bruprescott/CTDizzle/Arduino_MKRZero_Mk4/Documentation/Resources.md

This page will continue to be updated as resources are discovered.

### Datasheets and Part Documentation
- [Atlas-Scientific EC EZO Datasheet](https://www.atlas-scientific.com/_files/_datasheets/_circuit/EC_EZO_Datasheet.pdf)
- [Atlas-Scientific K1.0 Probe Datasheet](https://www.atlas-scientific.com/_files/_datasheets/_probe/EC_K_1.0_probe.pdf)
- [Atlas-Scientific EC Accuracy Graph](https://www.atlas-scientific.com/_files/instructions/conductivity_accuracy_graph.pdf)
- [Atlas-Scientific EC Wiring Diagram](https://www.atlas-scientific.com/_files/instructions/ezo-ec-wiringdiagram.pdf)
- [MS5837 Pressure Sensor Datasheet](http://www.te.com/commerce/DocumentDelivery/DDEController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)
- [TSYS01 Temperature Sensor Datasheet](http://www.te.com/commerce/DocumentDelivery/DDEController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)
- [Watertight Enclosure Specifications](http://docs.bluerobotics.com/watertight-enclosures/)

### Useful Examples
- [DeadOn RTC Guide](https://learn.sparkfun.com/tutorials/deadon-rtc-breakout-hookup-guide)
- [Adafruit Temp and Light Logger](https://github.com/adafruit/Light-and-Temp-logger)
- [mbed SD Module Example](https://developer.mbed.org/cookbook/SD-Card-File-System)
- [Atlas-Scientific Cable Cutting Guide](https://www.atlas-scientific.com/_files/_app_notes/how-to-properly-cut-probe-cables.pdf)

### Literature
- [SeaBird Appnote 14](http://www.seabird.com/document/an14-1978-practical-salinity-scale)
- [SeaBird Appnote 69](http://www.seabird.com/document/an69-conversion-pressure-depth)
- [SeaBird Appnote 82](http://www.seabird.com/document/an82-guide-specifying-ctd)
- [SeaBird Appnote 90](http://www.seabird.com/document/an90-absolute-salinity-and-teos-10-sea-birds-implementation)
- [Algorithms for computation of fundamental properties of seawater](http://www.jodc.go.jp/info/ioc_doc/UNESCO_tech/059832eb.pdf)
- [SBE Data Processing Manual](http://www.seabird.com/sites/default/files/documents/SBEDataProcessing_7.26.7.pdf)
