bruprescott/CTDizzle/Arduino_MKRZero_Mk4/Documentation/Images/3.PNG

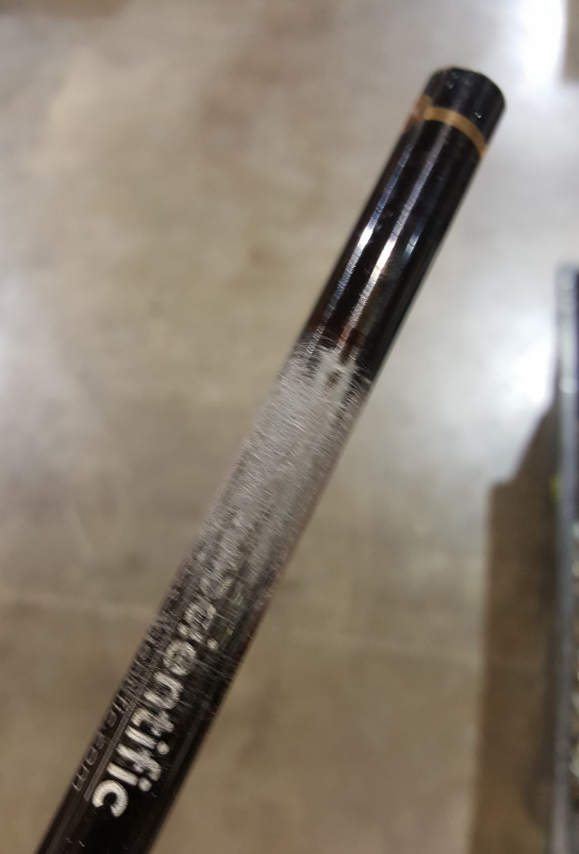
Arduino_MKRZero_Mk4/Documentation/Images/3.PNG
