bruprescott/CTDizzle/Arduino_MKRZero_Mk4/Documentation/Images/BadUrethane.jpg

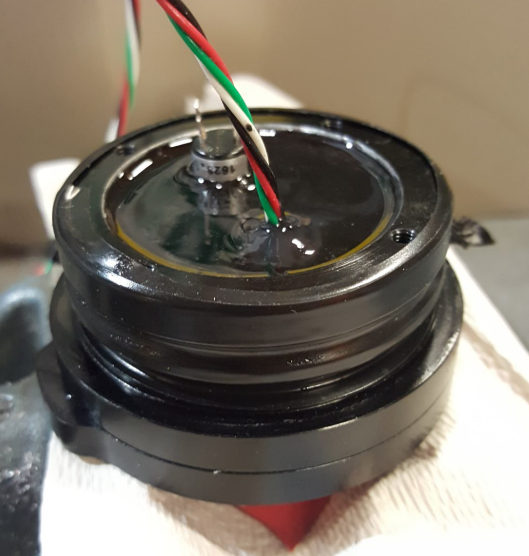
Arduino_MKRZero_Mk4/Documentation/Images/BadUrethane.jpg
