bruprescott/CTDizzle/Arduino_MKRZero_Mk4/Documentation/Images/CapInsideView.jpg

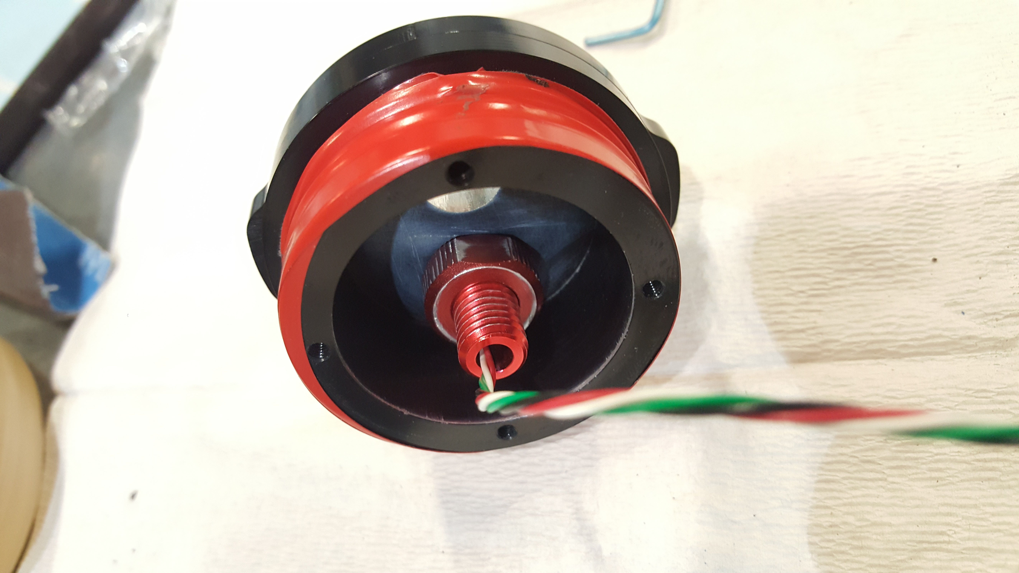
Arduino_MKRZero_Mk4/Documentation/Images/CapInsideView.jpg
