bruprescott/CTDizzle/Arduino_MKRZero_Mk4/Documentation/Images/Complete2.jpg

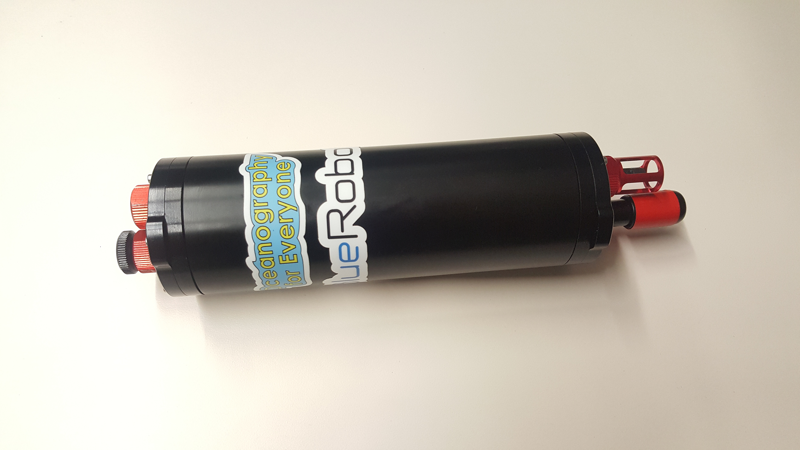
Arduino_MKRZero_Mk4/Documentation/Images/Complete2.jpg
