bruprescott/CTDizzle/Arduino_MKRZero_Mk4/Documentation/Images/EZOBend.jpg

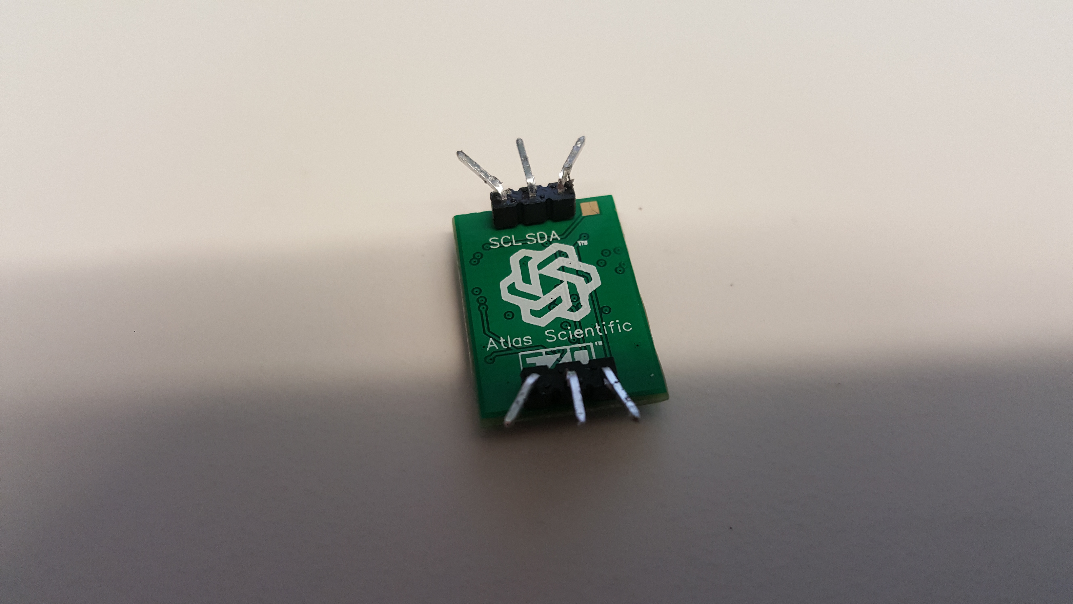
Arduino_MKRZero_Mk4/Documentation/Images/EZOBend.jpg
