bruprescott/CTDizzle/Arduino_MKRZero_Mk4/Documentation/Images/OceanShores1.PNG

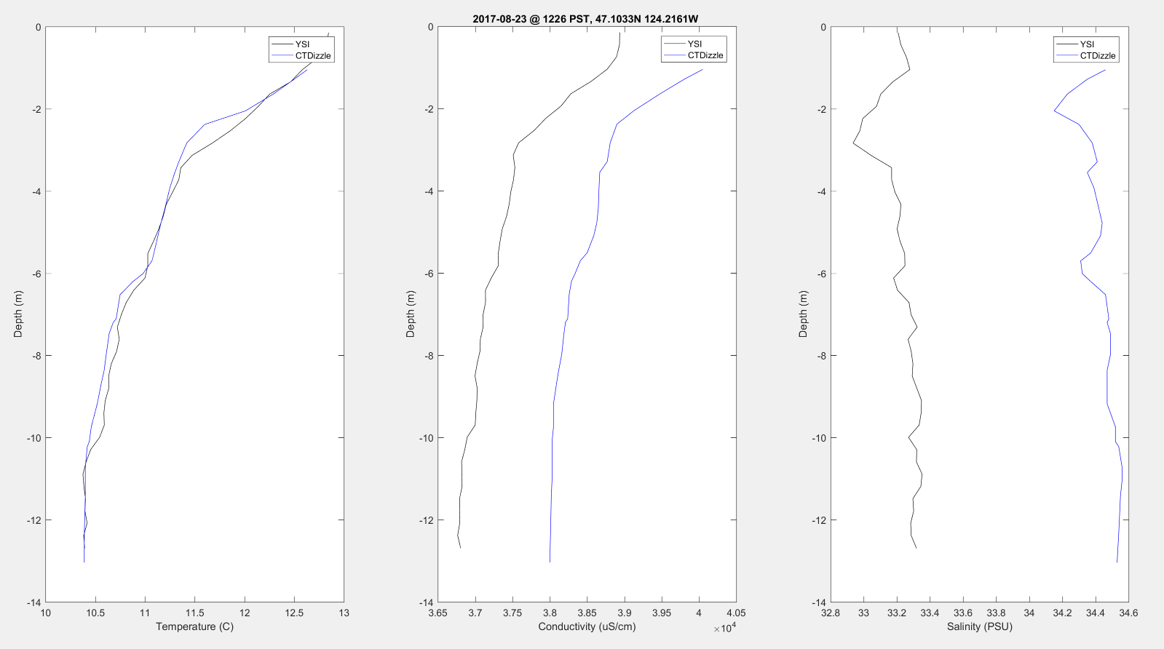
Arduino_MKRZero_Mk4/Documentation/Images/OceanShores1.PNG
