bruprescott/CTDizzle/Arduino_MKRZero_Mk4/Documentation/Images/PressureCap.jpg

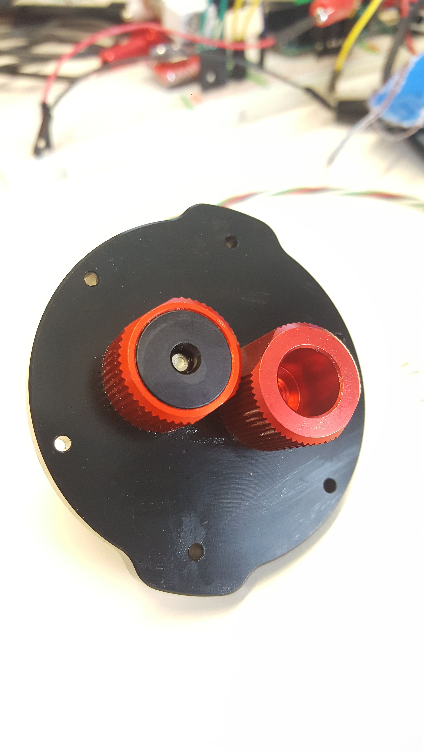
Arduino_MKRZero_Mk4/Documentation/Images/PressureCap.jpg
