bruprescott/CTDizzle/Arduino_MKRZero_Mk4/Documentation/Images/ProbeLeads.jpg

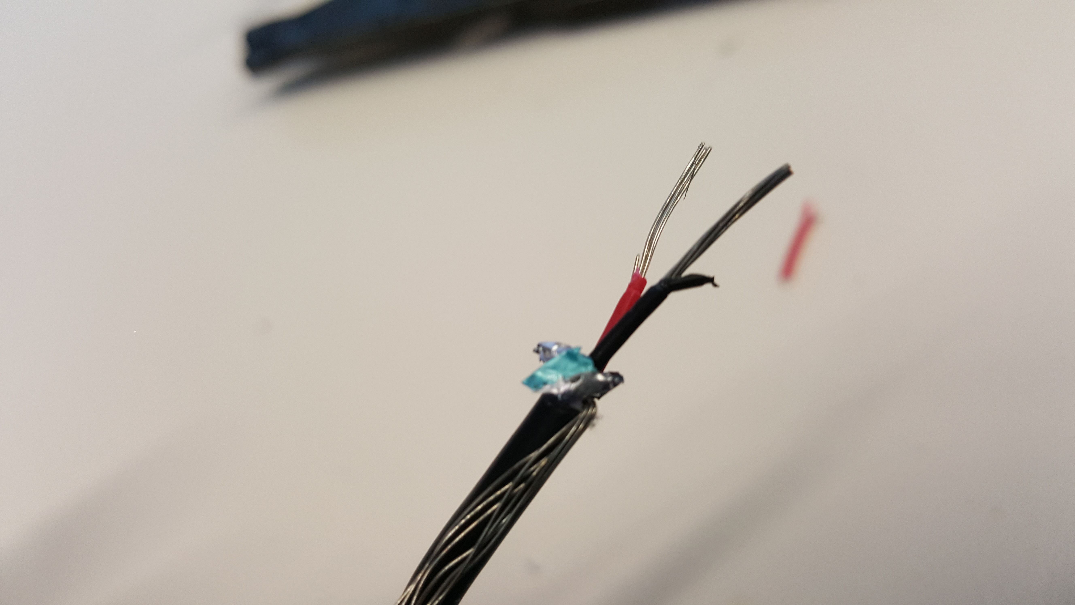
Arduino_MKRZero_Mk4/Documentation/Images/ProbeLeads.jpg
