bruprescott/CTDizzle/Arduino_MKRZero_Mk4/Documentation/Images/Protoboard2.jpg

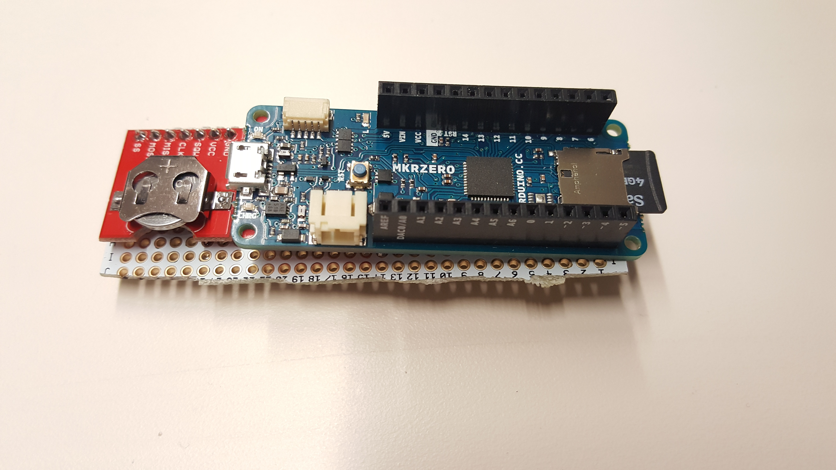
Arduino_MKRZero_Mk4/Documentation/Images/Protoboard2.jpg
