bruprescott/CTDizzle/Arduino_MKRZero_Mk4/Documentation/Images/SerialOutput.PNG

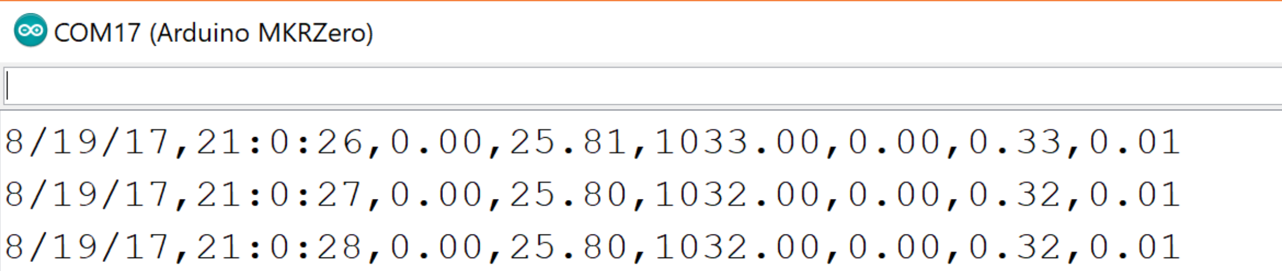
Arduino_MKRZero_Mk4/Documentation/Images/SerialOutput.PNG
