bruprescott/CTDizzle/Arduino_MKRZero_Mk4/Documentation/Images/TapedFlange.jpg

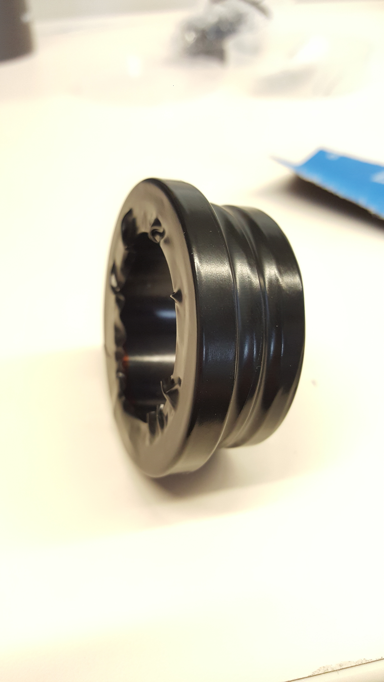
Arduino_MKRZero_Mk4/Documentation/Images/TapedFlange.jpg
