bruprescott/CTDizzle/Arduino_MKRZero_Mk4/Documentation/Images/WOPressure.jpg

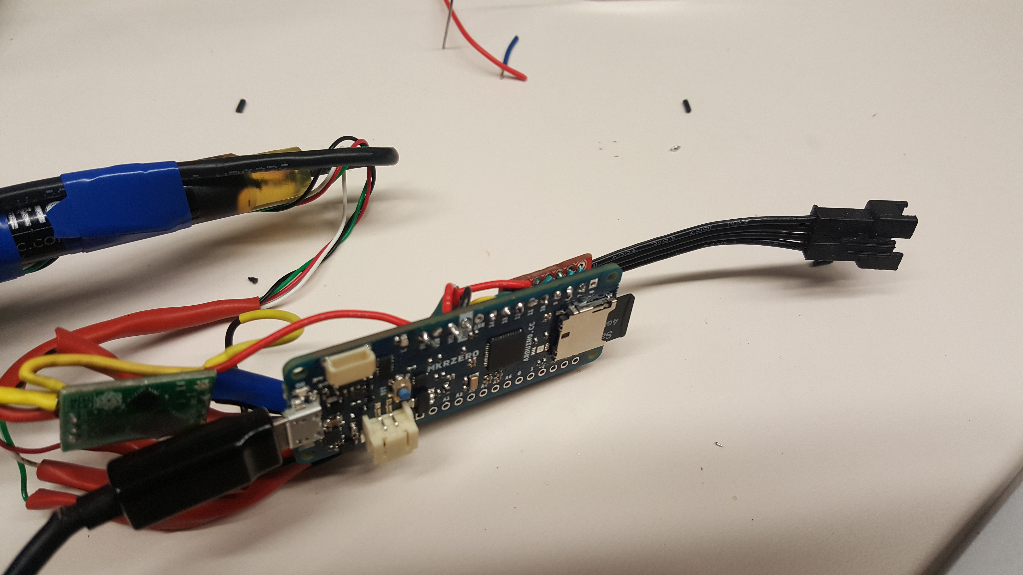
Arduino_MKRZero_Mk4/Documentation/Images/WOPressure.jpg
