bruprescott/CTDizzle/Adafruit_M0_Mk5/M0_PartsList.md

#### Primary Electronics List
|Part|Vendor|Price|Note|
|:---|:---|:---|:---|
|[Feather M0 Bluefruit LE](https://www.adafruit.com/product/2995?gclid=EAIaIQobChMIo-OggMH52wIVAtlkCh2x8AxQEAAYAiAAEgIEcPD_BwE)|Adafruit|$29.95|
|[Adalogger Featherwing](https://www.adafruit.com/product/2922)|Adafruit|$8.95|Includes RTC and SD module. +/- 12min per year accuracy
|[Celsius Fast-Response Temp Sensor](https://www.bluerobotics.com/store/electronics/celsius-sensor-r1/)|Blue Robotics|$56|+/- 0.1 C accuracy|
|[Bar30 High-Res Depth Sensor](https://www.bluerobotics.com/store/electronics/bar30-sensor-r1/)|Blue Robotics|$68|+/- 100 mbar accuracy
|[EC EZO K1.0 Kit](https://www.atlas-scientific.com/product_pages/kits/ec_k1_0_kit.html)|Atlas Scientific|$215|
|[Isolated EC EZO Carrier](https://www.atlas-scientific.com/product_pages/components/single_carrier_iso.html)|Atlas Scientific|$48|

#### Other Parts List
|Part|Vendor|Price|Note|
|:---|:---|:---|:---|
|[Short Feather Headers Kit - Female](https://www.adafruit.com/product/2940)|Adafruit|$2|
|[Short Feather Headers Kit - Male](https://www.adafruit.com/product/3002)|Adafruit|$1|
|[Featherwing Doubler](https://www.adafruit.com/product/2890)|Adafruit|$8|
|[Feather Terminal Blocks](https://www.adafruit.com/product/3173)|Adafruit|$6|
