bruprescott/CTDizzle/Arduino_MKRZero_Mk4/Mk4Parts_List.md

Here is a list of parts used to build the CTDizzle Mk4, their vendor location, and the approximate cost for each item. You can probably find them elsewhere for cheaper and in less quantity. Some items from this list will provide enough parts for multiple CTDs. Prices do not include shipping, but I've done my best to select as few of vendors as possible.

Please note that you can adapt the CTDizzle to use sensors and boards of your own choosing, but it is your responsibility to ensure that they are compatible. For example, if you are not concerned about size and want to implement a larger battery, you can use the 3" watertight enclosure, but be aware that you may need to drill your own holes or purchase a couple blank penetrators. 

#### Parts List
|Part|Vendor|Price|Note|
|:---|:---|:---|:---|
|[MKRZero](https://store.arduino.cc/usa/arduino-mkrzero)|Arduino USA|$21.90|
|[MKR ProtoShield](https://store.arduino.cc/usa/mkr-proto-shield)|Arduino USA|$6.99|
|[3.7V 2200mAh Li-Ion Battery](https://www.adafruit.com/product/1781)|Adafruit|$9.95|Last for about 60 hours if sampling at 1Hz|
|[Conductivity Kit 1.0](https://www.sparkfun.com/products/12908)|SparkFun|$195.71|Includes EC EZO, probe, and calibration solutions.|
|[Celsius Fast-Response Temp Sensor](https://www.bluerobotics.com/store/electronics/celsius-sensor-r1/)|Blue Robotics|$56|+/- 0.1 C accuracy|
|[Bar30 High-Res Depth Sensor](https://www.bluerobotics.com/store/electronics/bar30-sensor-r1/)|Blue Robotics|$68|
|[DeadOn RTC](https://www.sparkfun.com/products/10160)|SparkFun|$19.95|+/- 2 min drift per year|
|[12mm Coin Cell](https://www.sparkfun.com/products/337)|Sparkfun|$1.95|Needs to be replaced annually.|
|[MicroSD Card with Adapter](https://www.sparkfun.com/products/11609)|SparkFun|$13.95|
|[2" Water Tight Enclosure Kit - 6"](https://www.bluerobotics.com/store/watertight-enclosures/wte2-asm-r1/#configuration)|Blue Robotics|$111|Select the 6" aluminum main tube, two flanges, and two aluminum end caps with the two holes pre-drilled. Includes o-rings and screws.
|[Water Tight Enclosure Switch](http://www.bluerobotics.com/store/electronics/switch-10-5a-r1/)|Blue Robotics|$14|
|[Snappable Protoboard](https://www.sparkfun.com/products/13268)|SparkFun|$7.95|
|[4-Pin JST SM Plug Set](https://www.adafruit.com/product/578)|adafruit|$1.50|Allows removal of protoboard from unit.
|[6-Pin JST SM Plug Set](https://www.adafruit.com/product/1665)|adafruit|$1.50|Allows removal of protoboard from unit.
|[JST-PH Battery Extension Cable](https://www.adafruit.com/product/1131)|adafruit|$1.95|Allow easy use of external switch.
|[Cold Splice Connectors](https://www.adafruit.com/product/1496)|Adafruit|$2.95|Reduces need for pesky heat shrink.

#### Consumables List
|Item|Vendor|Price|Note|
|:---|:---|:---|:---|
|[Breakaway Header - Straight (x2)](https://www.sparkfun.com/products/116)|SparkFun|$3.00|
|[Loctite Marine Epoxy](https://www.amazon.com/Loctite-Marine-0-85-Fluid-Syringe-1405604/dp/B00KH62K50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)|Amazon|$4.99|You will need about one per end cap if building the 2" version. Buy three just in case.
|[Assorted 22 AWG - Solid Core Wire](https://www.sparkfun.com/products/11367)|SparkFun|$16.95|
|[Heat Shrink Kit](https://www.sparkfun.com/products/9353)|SparkFun|$7.95|
|[Kester 44 Solder 0.8mm](https://www.amazon.com/Kester-Rosin-Core-Solder-Spool/dp/B00068IJWC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)|Amazon|$33.43|1 lb of solder. Not necessary unless you want to solder more than the OpenCTD.
|[Desiccant Packs (10g)](https://www.amazon.com/Desiccant-Indicating-Chloride-Moisture-Absorbent/dp/B01MPYB16J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)|Amazon|$8.99|Plenty of replacements.
|Masking Tape|
|Sandpaper|
|Black Tape|
|70% Isopropyl Alcohol|
|Kimwipes|

#### Tools List
|Tool|Note|
|:---|:---|
|Needle Hemostats|Flat edges minimize marring of items.|
|2mm Hex Wrench|Used for end cap installation/removal|
|Solder Station|The XYTronic 258 is a decent starter solder tool.
|Multimeter|Not necessary, but useful for checking connectivity and current.
|Breadboard|
|Jumper Wires|
|Wire Stripper|Capable of stripping 20-26 gauge wire.
|Drill or Mill|
|Drillbit - 15/32" or 12mm|Size for Atlas Scientific EC Probe|
|microUSB Cable|Data-capable Android phone charger works too.|
|Round File|Used to size drilled hole.|

#### Not Necessary But Helpful Items
|Item|Vendor|Price|Note|
|:---|:---|:---|:---|
|[Potting Kit](http://www.bluerobotics.com/store/tools/tool-potting-kit-r1/)|Blue Robotics|$10|Keeps epoxy mess to a minimum.
|[Third Hand](https://www.sparkfun.com/products/9317)|SparkFun|$9.95|
|[O-Ring Pick](http://www.bluerobotics.com/store/tools/tool-o-ring-pick-r1/)|Blue Robotics|$4|They sometimes send you one for free if you buy a bunch of stuff.
|[Penetrator Wrench](http://www.bluerobotics.com/store/tools/tool-penetrator-wrench-r1/)|Blue Robotics|$12|
|[Calibration Solution K1.0 Set](https://www.atlas-scientific.com/product_pages/chemicals/ec-1_0.html)|Atlas-Scientific|$11|Already included in K1.0 kit, but it doesn't hurt to have extra on hand.|
