bruprescott/CTDizzle/Qduino_Mini_Mk3/Qduino_Parts_List.md

### As of 10 August 2017, this document is no longer being updated

Here is a list of parts used to build the CTDizzle Mk3, their vendor location, and the approximate cost for each item. You can probably find them elsewhere for cheaper and in less quantity. Some items from this list will provide enough parts for multiple CTDs. Prices do not include shipping.

Please note that you can adapt the CTDizzle to use sensors and boards of your own choosing, but it is your responsibility to ensure that they are compatible. 

#### Parts List
|Part|Vendor|Price|Note|
|:---|:---|:---|:---|
|[Qduino Mini](https://www.sparkfun.com/products/13614)|SparkFun|$29.95|
|[3.7V 6000mAh Li-Ion Battery](https://www.sparkfun.com/products/13856)|SparkFun|$29.95|Last for about 160 hours if sampling at 1Hz|
|[Conductivity Kit 1.0](https://www.sparkfun.com/products/12908)|SparkFun|$195.71|Includes EC EZO, probe, and calibration solutions.|
|[Celsius Fast-Response Temp Sensor](https://www.bluerobotics.com/store/electronics/celsius-sensor-r1/)|Blue Robotics|$56|+/- 0.1 C accuracy|
|[Bar30 High-Res Depth Sensor](https://www.bluerobotics.com/store/electronics/bar30-sensor-r1/)|Blue Robotics|$68|
|[DeadOn RTC](https://www.sparkfun.com/products/10160)|SparkFun|$19.95|+/- 2 min drift per year|
|[12mm Coin Cell](https://www.sparkfun.com/products/337)|Sparkfun|$1.95|Needs to be replaced annually.|
|[microSD Transflash Breakout](https://www.sparkfun.com/products/544)|SparkFun|$3.95|
|[MicroSD Card with Adapter](https://www.sparkfun.com/products/11609)|SparkFun|$13.95|
|[3" Water Tight Enclosure - 6"](https://www.bluerobotics.com/store/watertight-enclosures/wte3-p-tube-custom-r1/)|Blue Robotics|$35|Length can be custom ordered.
|[Aluminum O-Ring Flange (x2)](https://www.bluerobotics.com/store/watertight-enclosures/o-ring-flange-3-series/)|Blue Robotics|$48|
|[Aluminum End Cap - Blank (x2)](https://www.bluerobotics.com/store/watertight-enclosures/wte3-m-end-cap-r1/)|Blue Robotics|$20|Needs holes drilled for sensors. You can also buy end caps with holes pre-drilled. You will still need to drill out one of the holes for the conductivity sensor.
|[Vent and Plug](https://www.bluerobotics.com/store/watertight-enclosures/vent-asm-r1/)|Blue Robotics|$8|
|[Water Tight Enclosure Switch](http://www.bluerobotics.com/store/electronics/switch-10-5a-r1/)|Blue Robotics|$14|
|[Snappable Protoboard](https://www.sparkfun.com/products/13268)|SparkFun|$7.95|
|[4-Pin JST SM Plug Set](https://www.adafruit.com/product/578)|adafruit|$1.50|Allows removal of protoboard from unit.
|[2-Pin JST SM Plug Set](https://www.adafruit.com/product/2880)|adafruit|$0.75|Allows removal of protoboard from unit.
|[JST-PH Battery Extension Cable](https://www.adafruit.com/product/1131)|adafruit|$1.95|Allow easy use of external switch.

#### Consumables List
|Item|Vendor|Price|Note|
|:---|:---|:---|:---|
|[Breakaway Header - Straight (x2)](https://www.sparkfun.com/products/116)|SparkFun|$3|
|[2-Ton Marine Epoxy (x6)](https://www.amazon.com/dp/B00JN4SL3C/ref=twister_B06ZZ6NM7S?_encoding=UTF8&th=1)|Amazon|$28.80|Amount used is up to you. I recommend using at least two tubes per end cap. **Next build is going to test out 75A urethane.**
|[Assorted 22 AWG - Solid Core Wire](https://www.sparkfun.com/products/11367)|SparkFun|$16.95|
|[Heat Shrink Kit](https://www.sparkfun.com/products/9353)|SparkFun|$7.95|
|[Silicon Grease](http://www.bluerobotics.com/store/tools/tool-silicone-grease-10g-r1/)|Blue Robotics|$3|
|[Kester 44 Solder](https://www.amazon.com/Kester-Rosin-Core-Solder-Spool/dp/B00068IJWC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)|Amazon|$33.43|1 lb of solder. Not necessary unless you want to solder more than the OpenCTD.
|[Desiccant Packs (10g)](https://www.amazon.com/Desiccant-Indicating-Chloride-Moisture-Absorbent/dp/B01MPYB16J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)|Amazon|$8.99|Plenty of replacements.
|Masking Tape|
|Sandpaper|
|Black Tape|
|70% Isopropyl Alcohol|
|Kimwipes|

#### Tools List
|Tool|Note|
|:---|:---|
|Needle Hemostats|Flat edges minimize marring of items.|
|2.5mm Hex Wrench|Used for end cap installation/removal|
|Solder Station|Hakko appears to make decent soldering irons if you do not have one on hand. 
|Multimeter|Not necessary, but useful for checking connectivity.
|Breadboard|
|Jumper Wires|
|Wire Stripper|
|Drill or Mill|
|Drillbit - 10mm|Size for Blue Robotics bulkheads|
|Drillbit - 12mm|Size for Atlas Scientific EC Probe|
|microUSB Cable|Data-capable Android phone charger works too.|

#### Not Necessary But Helpful Items
|Item|Vendor|Price|Note|
|:---|:---|:---|:---|
|[Potting Kit](http://www.bluerobotics.com/store/tools/tool-potting-kit-r1/)|Blue Robotics|$10|Keeps epoxy mess to a minimum.
|[Third Hand](https://www.sparkfun.com/products/9317)|SparkFun|$9.95|
|[O-Ring Pick](http://www.bluerobotics.com/store/tools/tool-o-ring-pick-r1/)|Blue Robotics|$4|
|[Penetrator Wrench](http://www.bluerobotics.com/store/tools/tool-penetrator-wrench-r1/)|Blue Robotics|$12|
|[Calibration Solution K1.0 Set](https://www.atlas-scientific.com/product_pages/chemicals/ec-1_0.html)|Atlas-Scientific|$5.31|$11|Already included in K1.0 kit, but it doesn't hurt to have extra on hand.|
