bruprescott/CTDizzle/Arduino_MKRZero_Mk4/Documentation/Images/FinalTest2.jpg

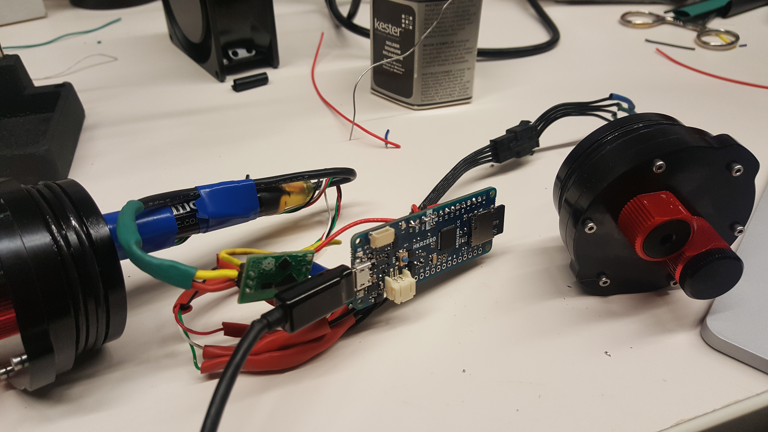
Arduino_MKRZero_Mk4/Documentation/Images/FinalTest2.jpg
