bruprescott/CTDizzle/(commit log)

2017-06-07 Create Bill of Materials
2017-08-08 Rename Arduino Files/CTDizzle_MKRZERO.ino to Arduino Files/MKRZero/CTDizzle_MKRZERO.ino
2017-08-08 Rename Arduino Files/QduinoOpCode.ino to Arduino Files/MKRZero/QduinoOpCode.ino
2017-08-08 Rename Arduino Files/EC_Cal.ino to Arduino Files/Qduino/Qduino_EC_Cal.ino
2017-08-08 Rename Arduino Files/MKRZero/QduinoOpCode.ino to Arduino Files/Qduino/QduinoOpCode.ino
2017-08-08 Edited Battery Procedure
2017-08-09 EZO Calibration Sketch
2017-08-19 Rename Arduino Files/Qduino/Qduino_OpCode.ino to Legacy/Qduino_OpCode.ino
2017-08-19 Rename Arduino Files/MKRZero/MKRZero_EC_Cal to MKRZero/ArduinoFiles/MKRZero_EC_Cal.ino
2017-08-19 Rename Arduino Files/MKRZero/MKRZero_OpCode.ino to MKRZero/ArduinoFiles/MKRZero_OpCode.ino
2017-08-19 Updated atmospheric pressure assumption.
2017-09-05 Added default temperature reset.
2018-01-19 Corrected pressure to depth calculation.
2018-04-09 Back to basics.
    Only prints date, time, EC, T, P to a CSV.
2018-04-22 Pressure Sensor -> Grease
2018-08-19 Create ArduinoFiles
