bruprescott/CTDizzle/Arduino_MKRZero_Mk4/Documentation/Images/EC_TCap.jpg

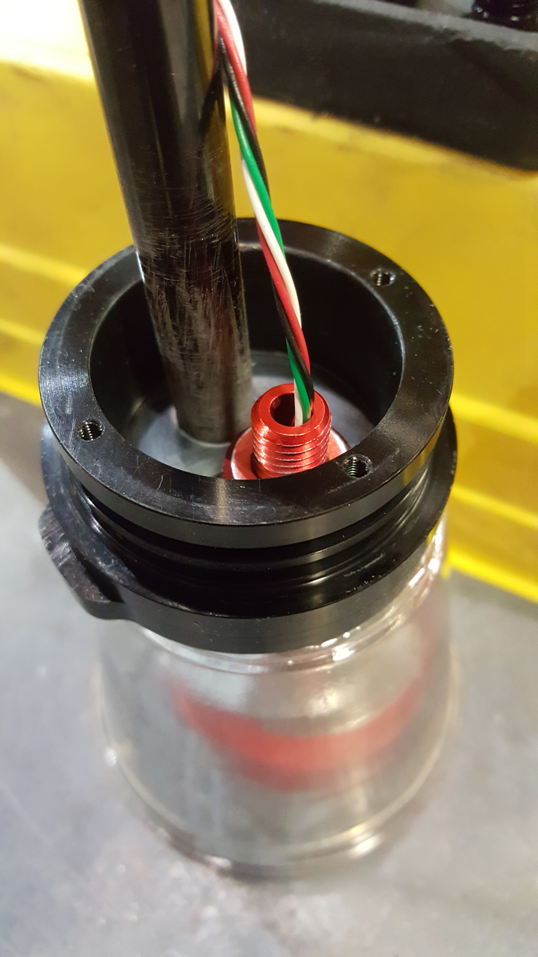
Arduino_MKRZero_Mk4/Documentation/Images/EC_TCap.jpg
