bruprescott/CTDizzle/Arduino_MKRZero_Mk4/Documentation/Images/Heatshrink.jpg

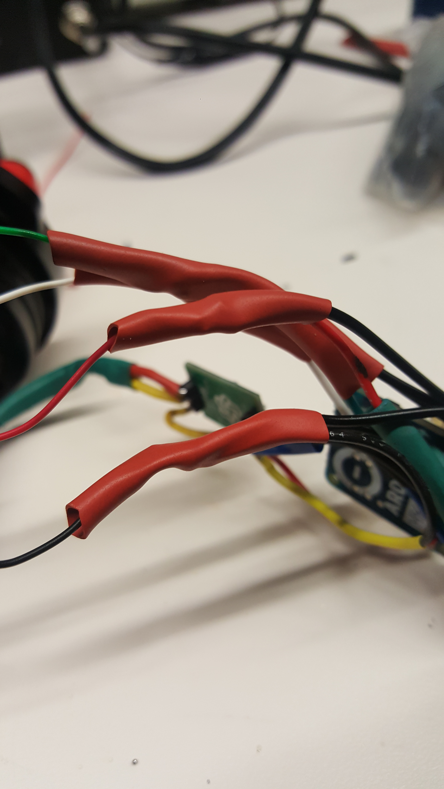
Arduino_MKRZero_Mk4/Documentation/Images/Heatshrink.jpg
