bruprescott/CTDizzle/Arduino_MKRZero_Mk4/Documentation/Images/JST6.jpg

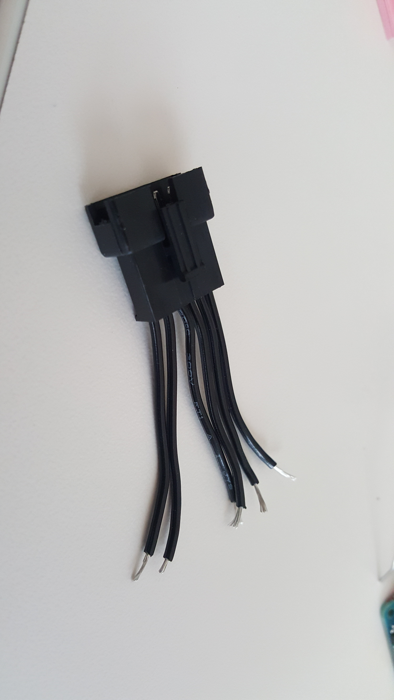
Arduino_MKRZero_Mk4/Documentation/Images/JST6.jpg
