bruprescott/CTDizzle/Arduino_MKRZero_Mk4/Documentation/Images/MKRZero.jpg

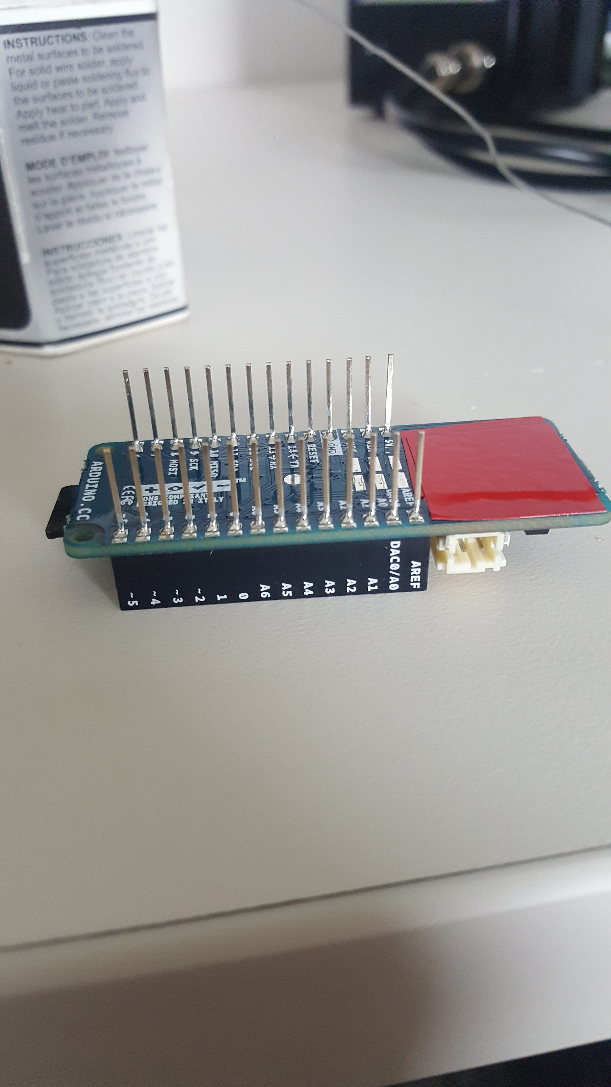
Arduino_MKRZero_Mk4/Documentation/Images/MKRZero.jpg
