bruprescott/CTDizzle/Arduino_MKRZero_Mk4/Documentation/Images/Pins.jpg

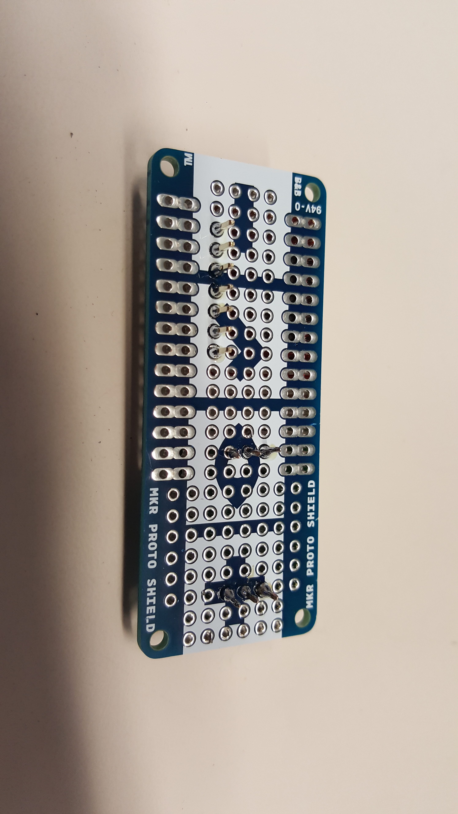
Arduino_MKRZero_Mk4/Documentation/Images/Pins.jpg
