bruprescott/CTDizzle/Arduino_MKRZero_Mk4/Documentation/Images/PressureCap2.jpg

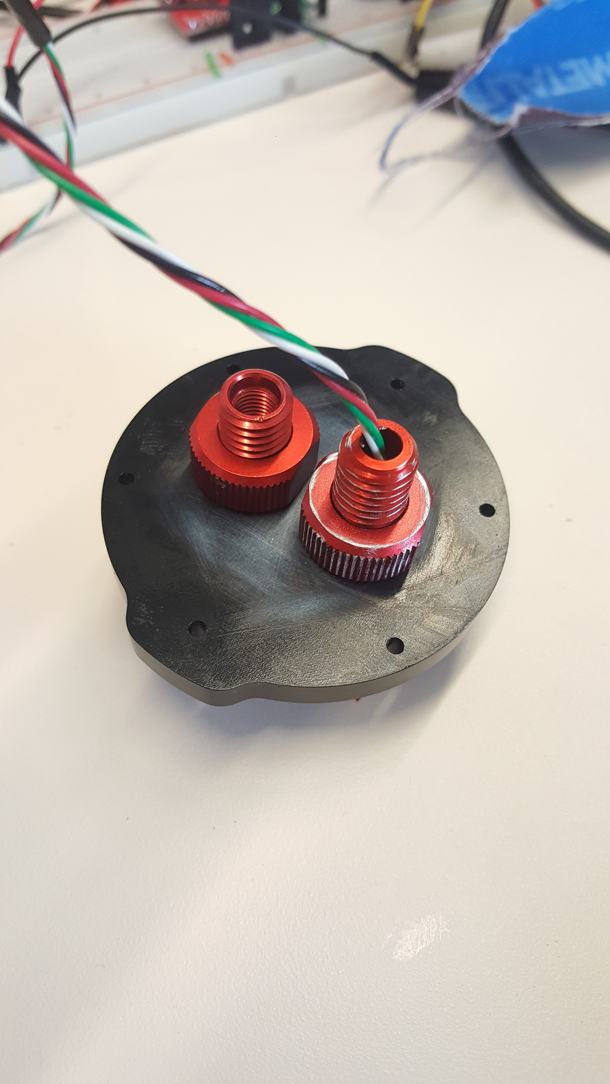
Arduino_MKRZero_Mk4/Documentation/Images/PressureCap2.jpg
