bruprescott/CTDizzle/Arduino_MKRZero_Mk4/Documentation/Images/PressureTape.jpg

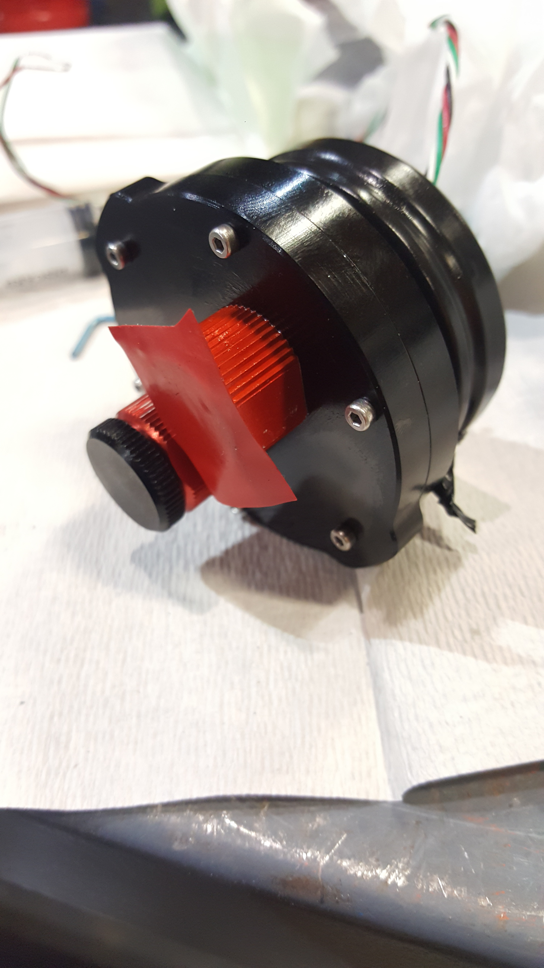
Arduino_MKRZero_Mk4/Documentation/Images/PressureTape.jpg
