bruprescott/CTDizzle/Arduino_MKRZero_Mk4/Documentation/Images/Protoboard1.jpg

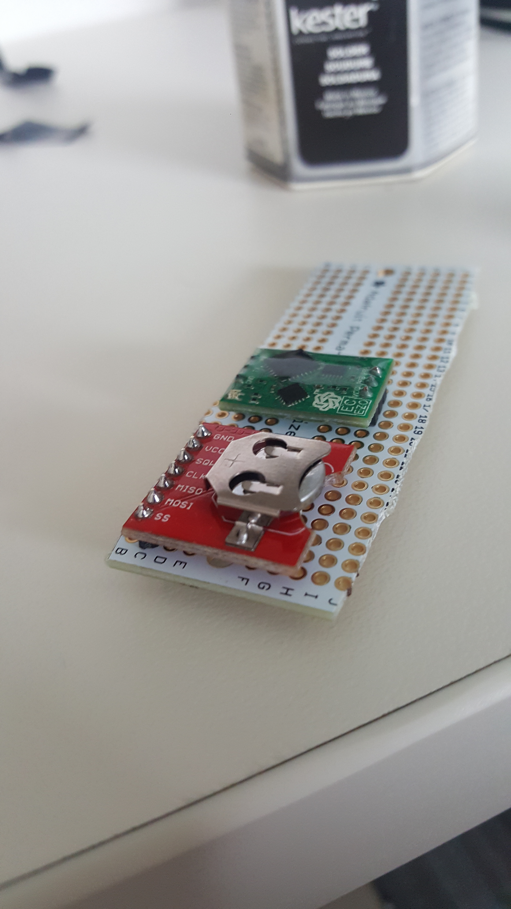
Arduino_MKRZero_Mk4/Documentation/Images/Protoboard1.jpg
