bruprescott/CTDizzle/Arduino_MKRZero_Mk4/Documentation/Images/RoughFlange.jpg

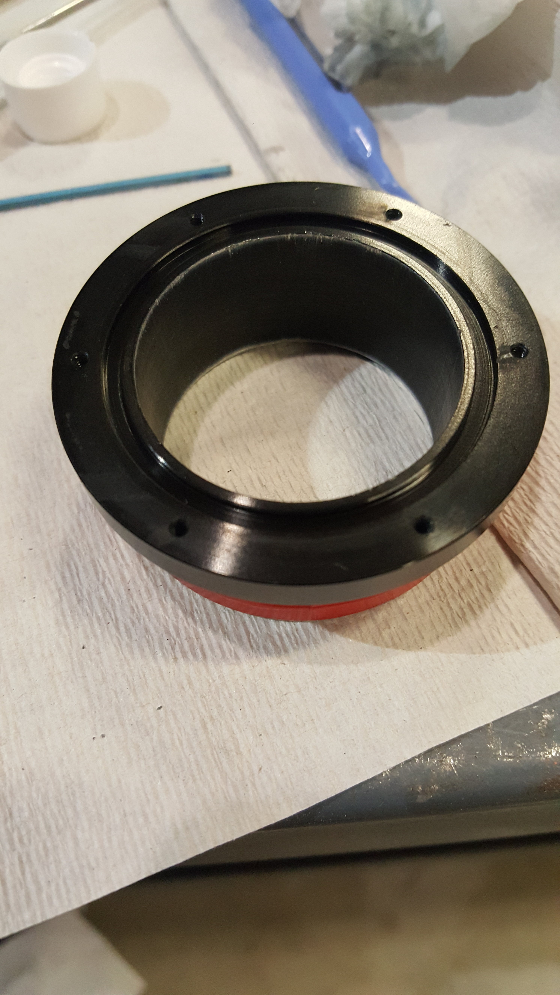
Arduino_MKRZero_Mk4/Documentation/Images/RoughFlange.jpg
