bruprescott/CTDizzle/Arduino_MKRZero_Mk4/Documentation/Images/RoughProbe.jpg

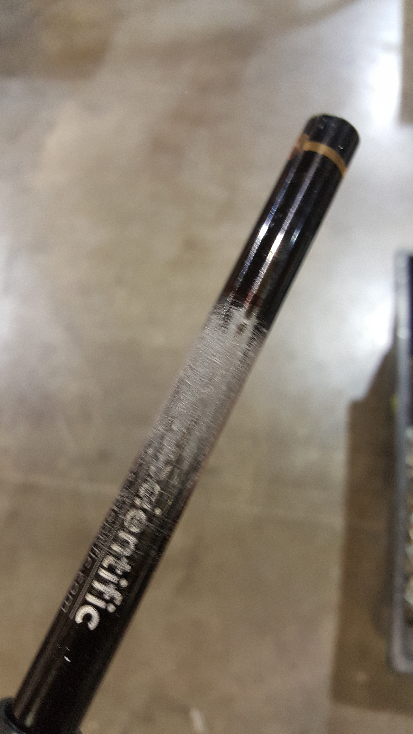
Arduino_MKRZero_Mk4/Documentation/Images/RoughProbe.jpg
