bruprescott/CTDizzle/Arduino_MKRZero_Mk4/Documentation/Images/RTC_EZO.jpg

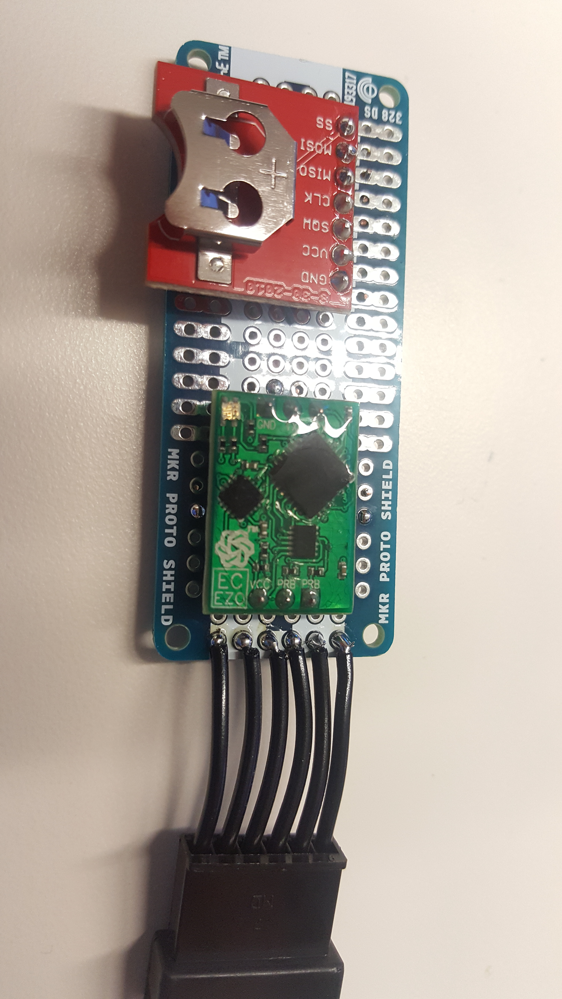
Arduino_MKRZero_Mk4/Documentation/Images/RTC_EZO.jpg
