bruprescott/CTDizzle/Arduino_MKRZero_Mk4/Documentation/Images/RTCEZO.jpg

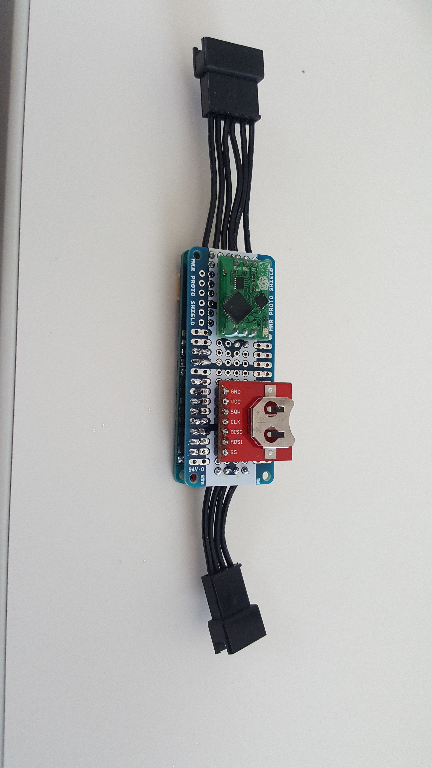
Arduino_MKRZero_Mk4/Documentation/Images/RTCEZO.jpg
