bruprescott/CTDizzle/Arduino_MKRZero_Mk4/Documentation/Images/RTCPrep.jpg

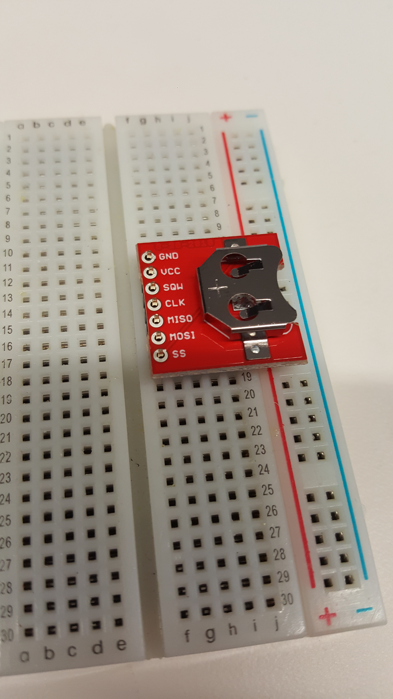
Arduino_MKRZero_Mk4/Documentation/Images/RTCPrep.jpg
