bruprescott/CTDizzle/Arduino_MKRZero_Mk4/Documentation/Images/ScrewsTape.jpg

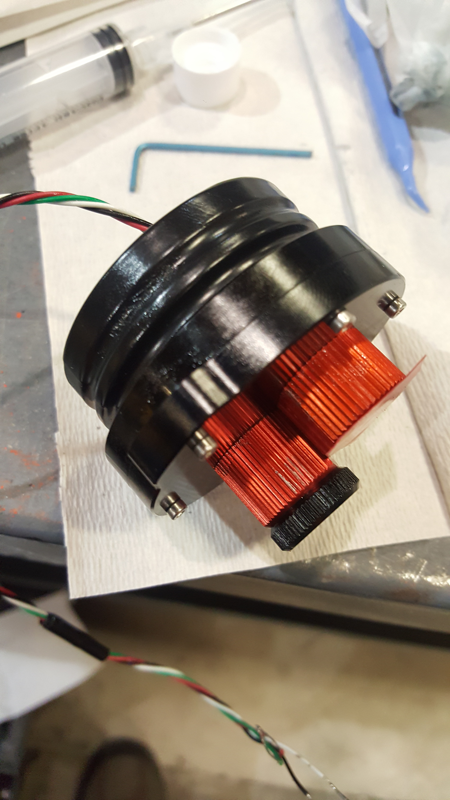
Arduino_MKRZero_Mk4/Documentation/Images/ScrewsTape.jpg
