bruprescott/CTDizzle/Arduino_MKRZero_Mk4/Documentation/Images/TinnedLeads.jpg

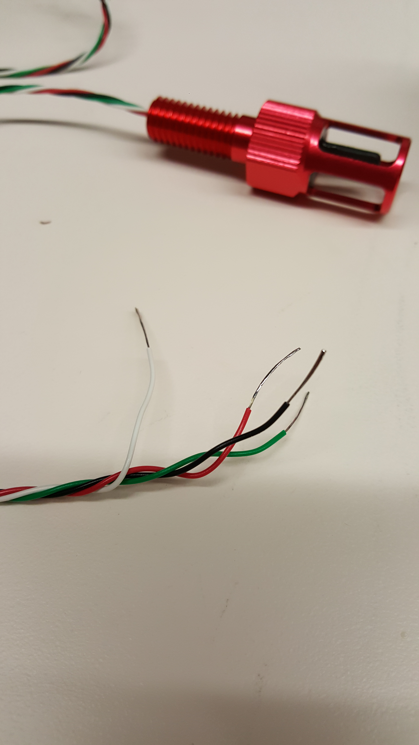
Arduino_MKRZero_Mk4/Documentation/Images/TinnedLeads.jpg
