bruprescott/CTDizzle/Arduino_MKRZero_Mk4/Documentation/Images/Urethane1.jpg

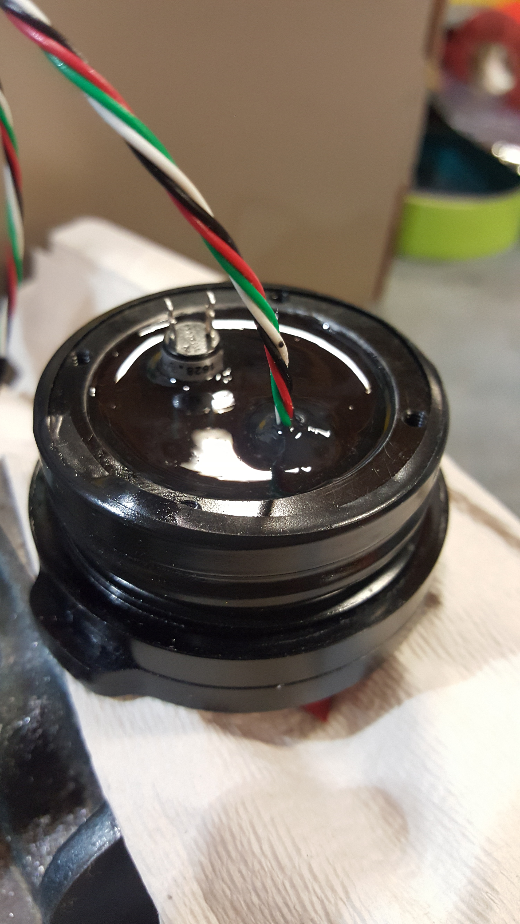
Arduino_MKRZero_Mk4/Documentation/Images/Urethane1.jpg
