bruprescott/CTDizzle/Arduino_MKRZero_Mk4/Documentation/Images/UrethaneBottles.jpg

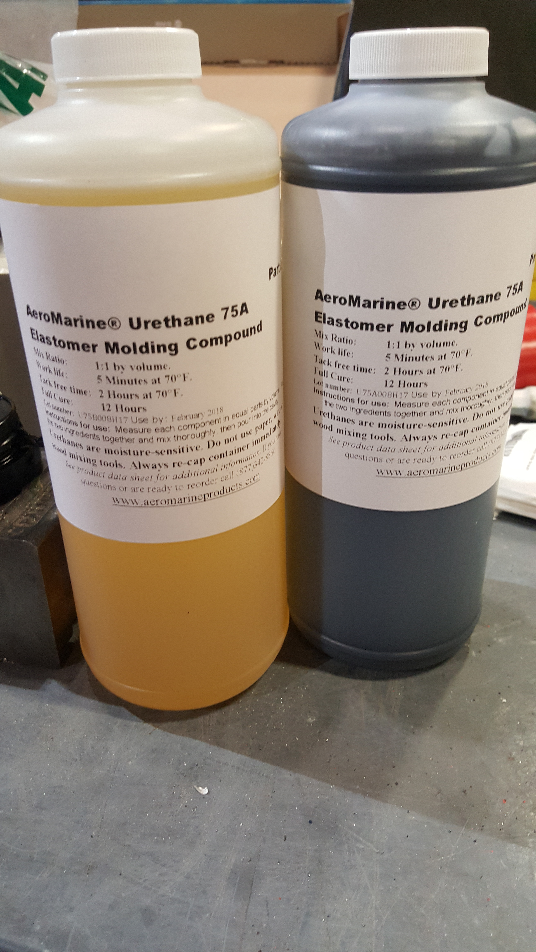
Arduino_MKRZero_Mk4/Documentation/Images/UrethaneBottles.jpg
