bruprescott/CTDizzle/Arduino_MKRZero_Mk4/Documentation/Images/UrethaneCloseUp.jpg

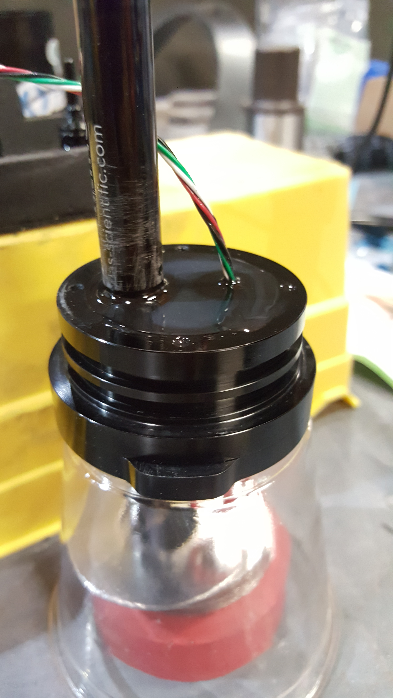
Arduino_MKRZero_Mk4/Documentation/Images/UrethaneCloseUp.jpg
