bruprescott/CTDizzle/Arduino_MKRZero_Mk4/Documentation/Images/WireBus.jpg

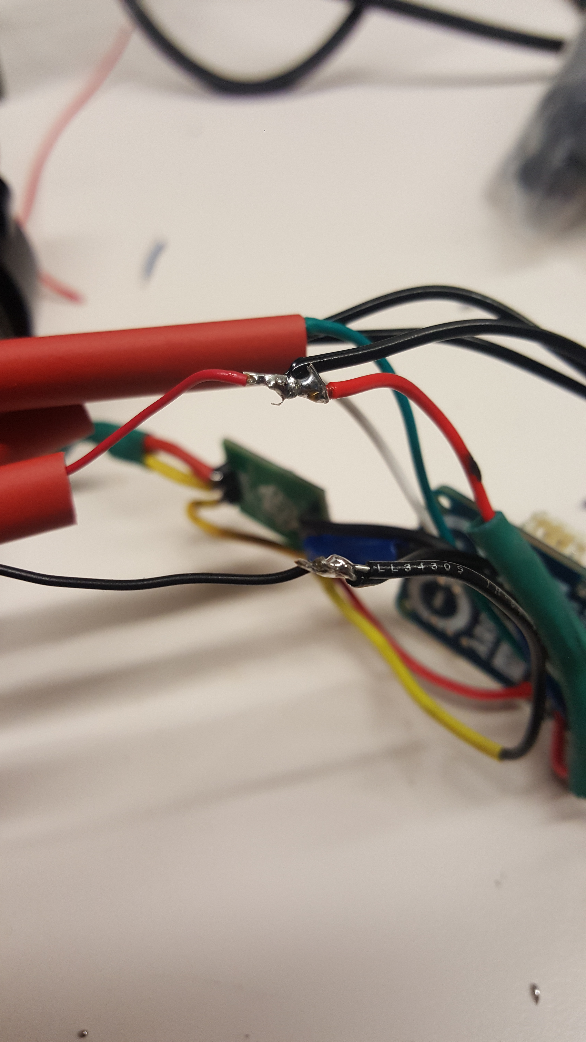
Arduino_MKRZero_Mk4/Documentation/Images/WireBus.jpg
