bruprescott/CTDizzle/Arduino_MKRZero_Mk4/Documentation/Images/RTCEZO2.jpg

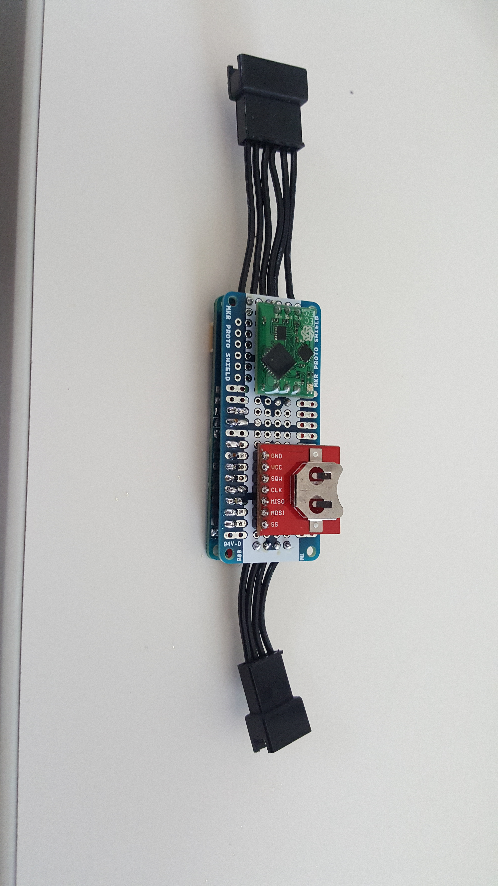
[picture p47: MKRZero/Documentation/Images/RTCEZO2.jpg]
Arduino_MKRZero_Mk4/Documentation/Images/RTCEZO2.jpg
