bruprescott/CTDizzle/Arduino_MKRZero_Mk4/Documentation/Images/MKRMale.jpg

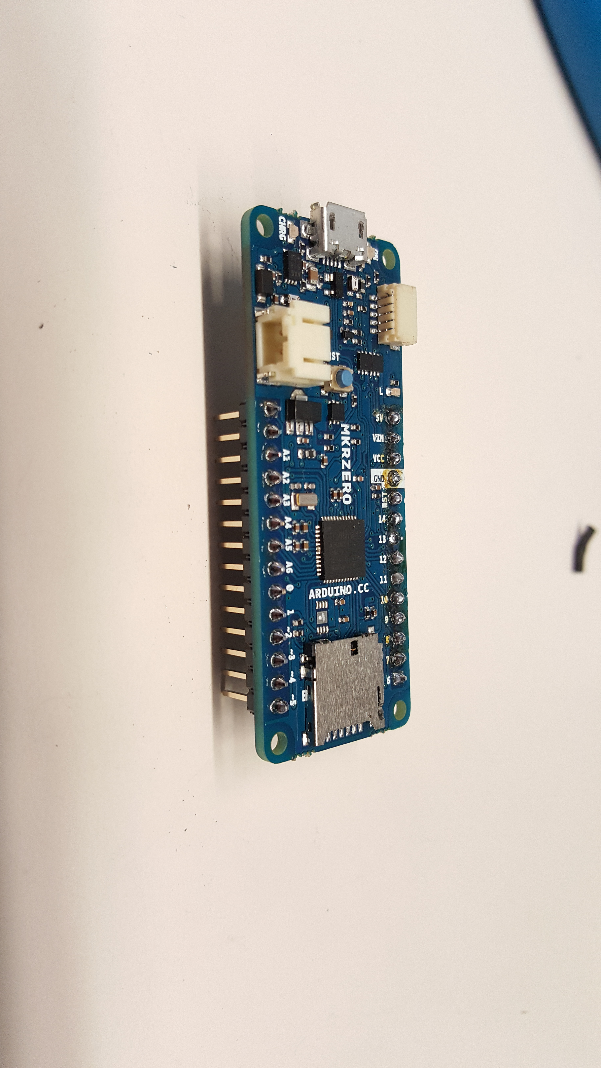
[picture p48: MKRZero/Documentation/Images/MKRMale.jpg]
Arduino_MKRZero_Mk4/Documentation/Images/MKRMale.jpg
