bruprescott/CTDizzle/Arduino_MKRZero_Mk4/Documentation/Images/BendingWires.jpg

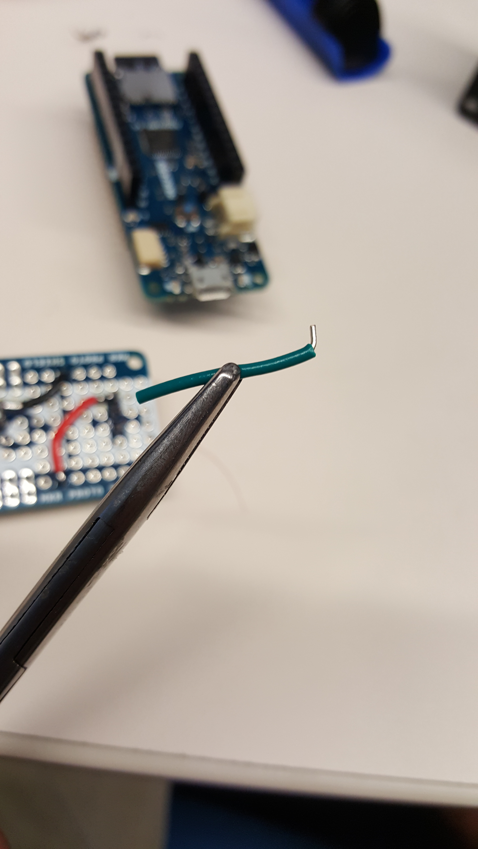
[picture p49: MKRZero/Documentation/Images/BendingWires.jpg]
Arduino_MKRZero_Mk4/Documentation/Images/BendingWires.jpg
