bruprescott/CTDizzle/Arduino_MKRZero_Mk4/Documentation/Images/VCCGND.jpg

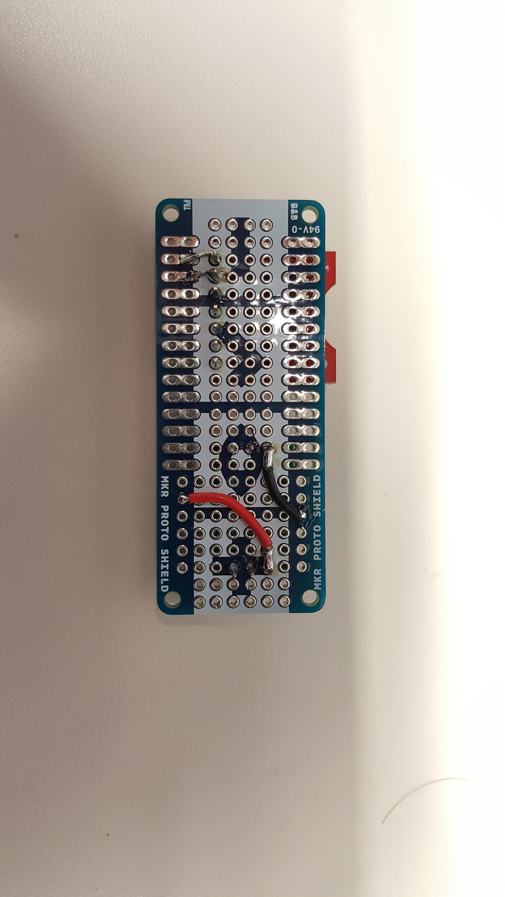
[picture p50: MKRZero/Documentation/Images/VCCGND.jpg]
Arduino_MKRZero_Mk4/Documentation/Images/VCCGND.jpg
