bruprescott/CTDizzle/Arduino_MKRZero_Mk4/Documentation/Images/SolderWires3.jpg

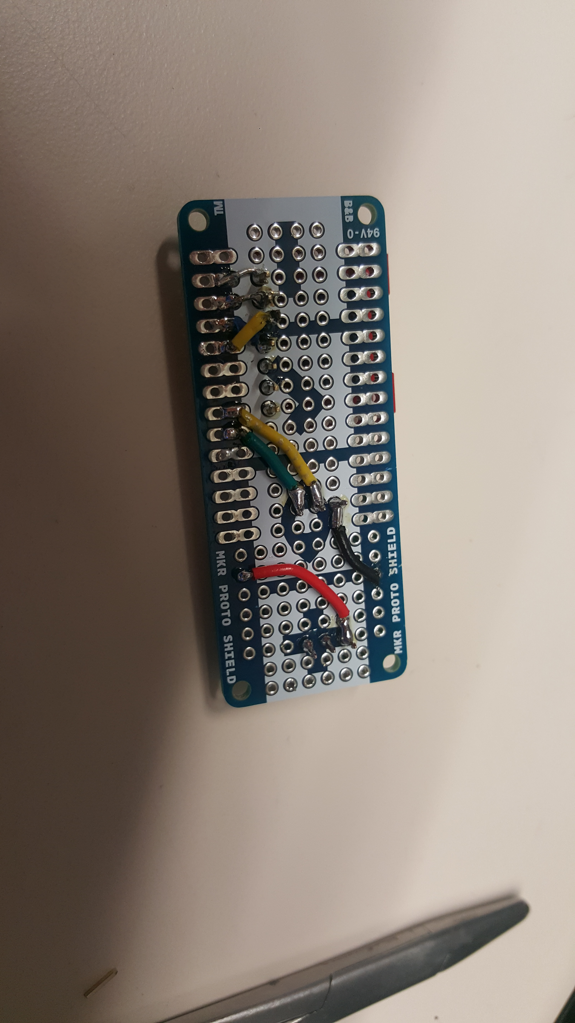
[picture p51: MKRZero/Documentation/Images/SolderWires3.jpg]
Arduino_MKRZero_Mk4/Documentation/Images/SolderWires3.jpg
