bruprescott/CTDizzle/Arduino_MKRZero_Mk4/Documentation/Images/SolderWires4.jpg

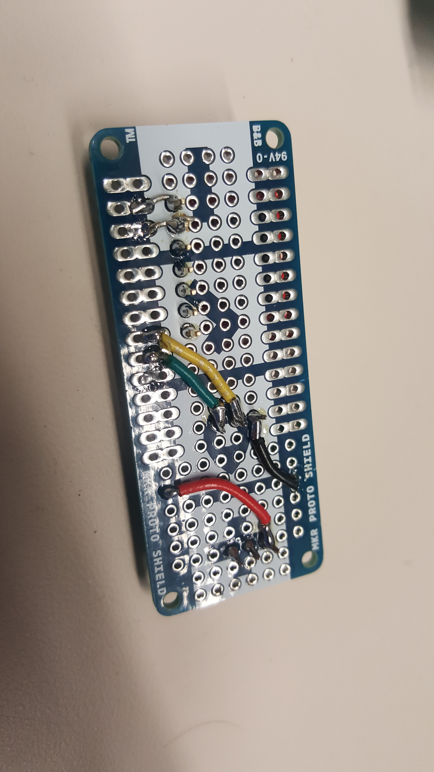
[picture p52: MKRZero/Documentation/Images/SolderWires4.jpg]
Arduino_MKRZero_Mk4/Documentation/Images/SolderWires4.jpg
