bruprescott/CTDizzle/Arduino_MKRZero_Mk4/Documentation/Images/Bus.jpg

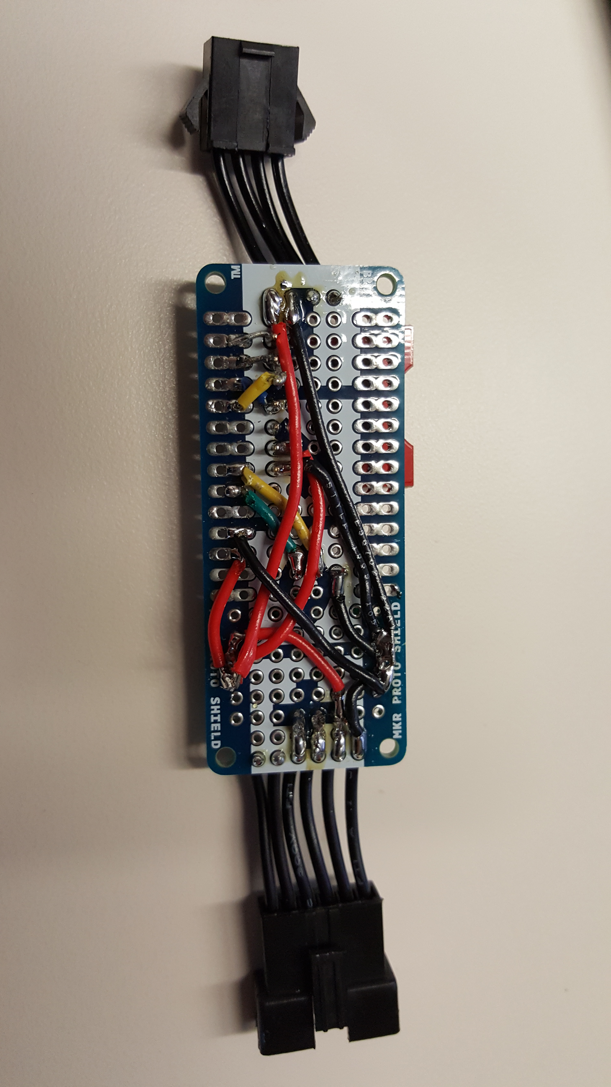
[picture p53: MKRZero/Documentation/Images/Bus.jpg]
Arduino_MKRZero_Mk4/Documentation/Images/Bus.jpg
