bruprescott/CTDizzle/Arduino_MKRZero_Mk4/Documentation/Images/All_Soldered.jpg

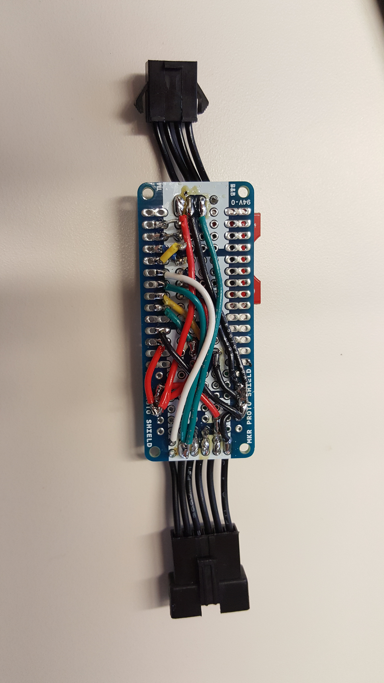
[picture p54: MKRZero/Documentation/Images/All_Soldered.jpg]
Arduino_MKRZero_Mk4/Documentation/Images/All_Soldered.jpg
