bruprescott/CTDizzle/Arduino_MKRZero_Mk4/Documentation/Images/Solder_pool_2.jpg

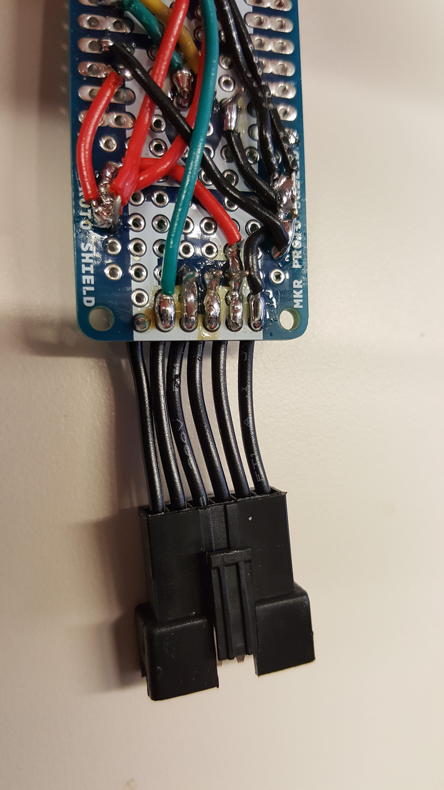
[picture p55: MKRZero/Documentation/Images/Solder_pool_2.jpg]
Arduino_MKRZero_Mk4/Documentation/Images/Solder_pool_2.jpg
