bruprescott/CTDizzle/Arduino_MKRZero_Mk4/Documentation/Images/MainZero.jpg

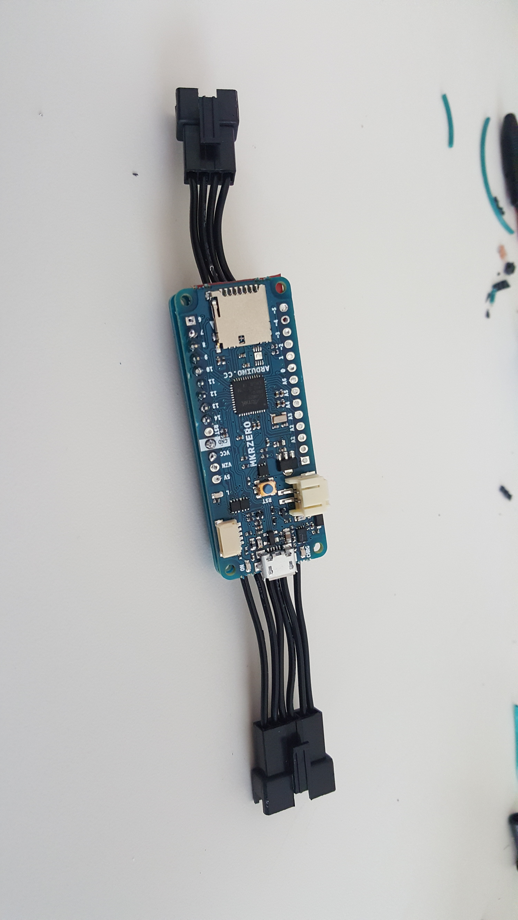
[picture p57: MKRZero/Documentation/Images/MainZero.jpg]
Arduino_MKRZero_Mk4/Documentation/Images/MainZero.jpg
