bruprescott/CTDizzle/Arduino_MKRZero_Mk4/Documentation/Images/GNDVCC.jpg

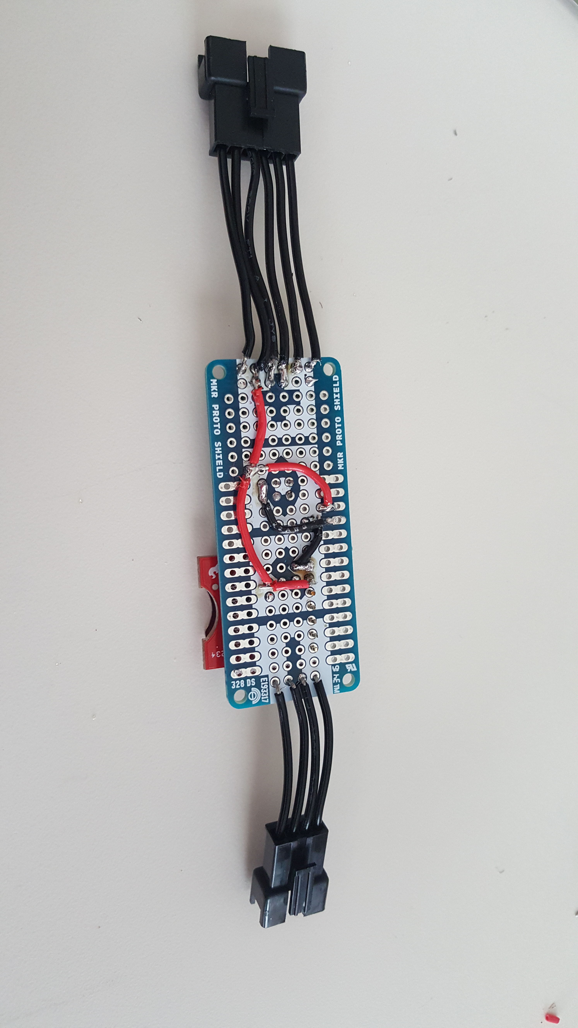
[picture p60: MKRZero/Documentation/Images/GNDVCC.jpg]
Arduino_MKRZero_Mk4/Documentation/Images/GNDVCC.jpg
