bruprescott/CTDizzle/Arduino_MKRZero_Mk4/Documentation/Images/Split.jpg

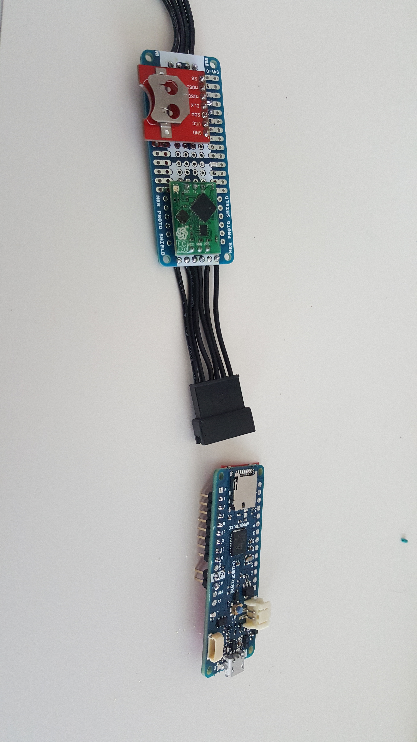
[picture p61: MKRZero/Documentation/Images/Split.jpg]
Arduino_MKRZero_Mk4/Documentation/Images/Split.jpg
