bruprescott/CTDizzle/Arduino_MKRZero_Mk4/Documentation/Images/Split2.jpg

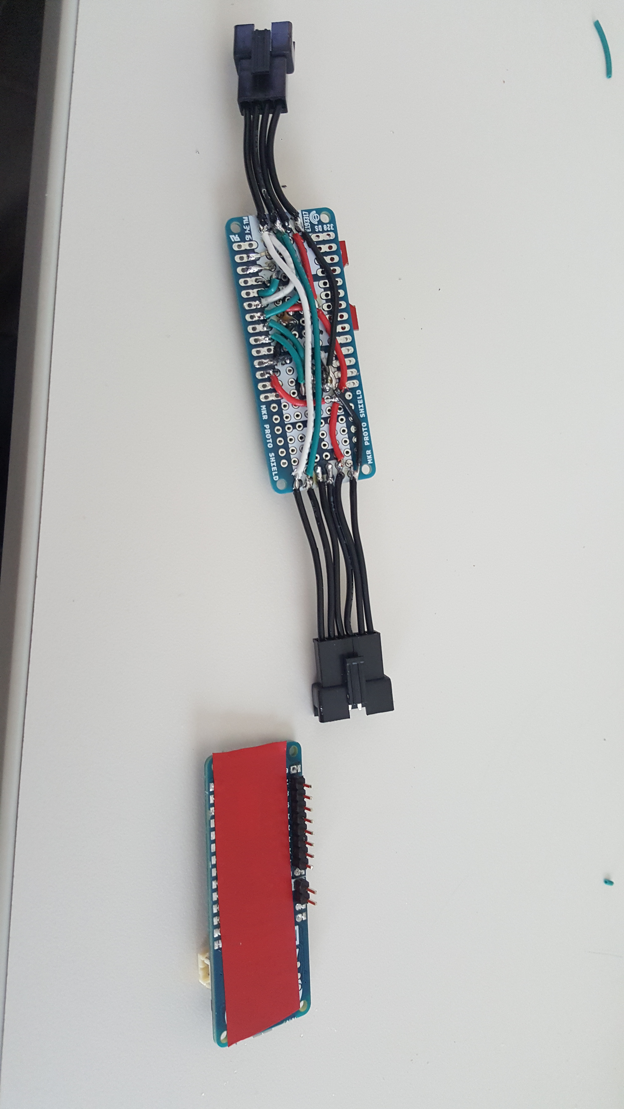
[picture p62: MKRZero/Documentation/Images/Split2.jpg]
Arduino_MKRZero_Mk4/Documentation/Images/Split2.jpg
