bruprescott/CTDizzle/Documentation/Images/20170605_104802_001.jpg

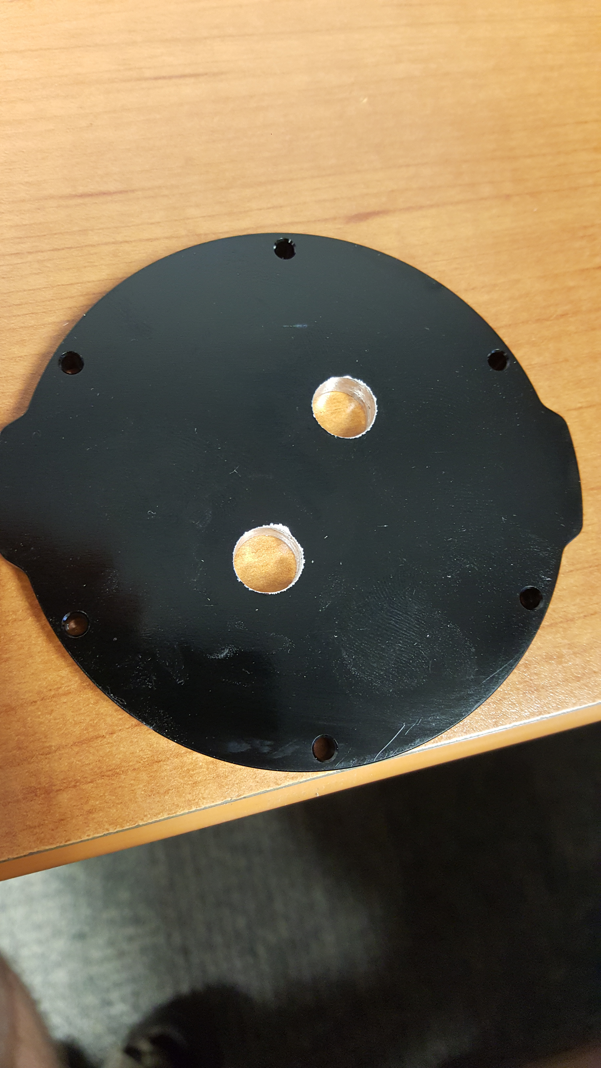
[picture p64: Documentation/Images/HolesEndcap.jpg]
Documentation/Images/20170605_104802_001.jpg
