bruprescott/CTDizzle/Documentation/Images/20170605_151845.jpg

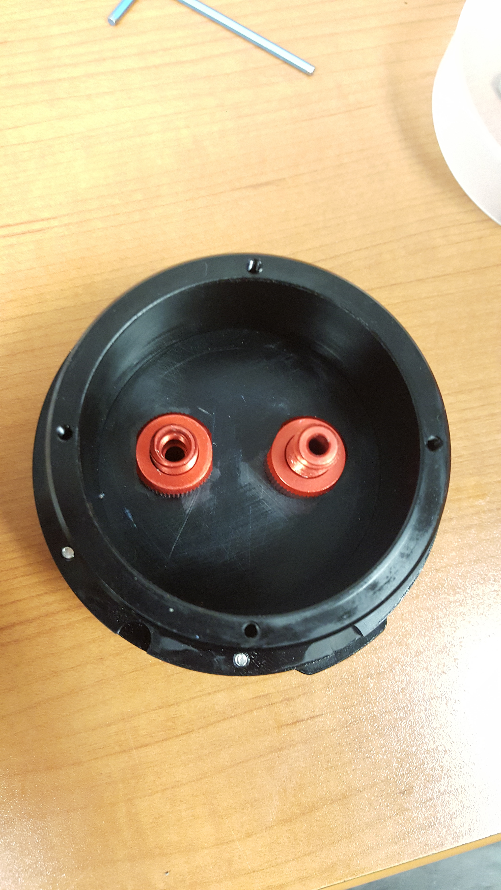
[picture p65: Documentation/Images/NoEpoxySwitchVent.jpg]
Documentation/Images/20170605_151845.jpg
