bruprescott/CTDizzle/Documentation/Images/SwitchCable.jpg

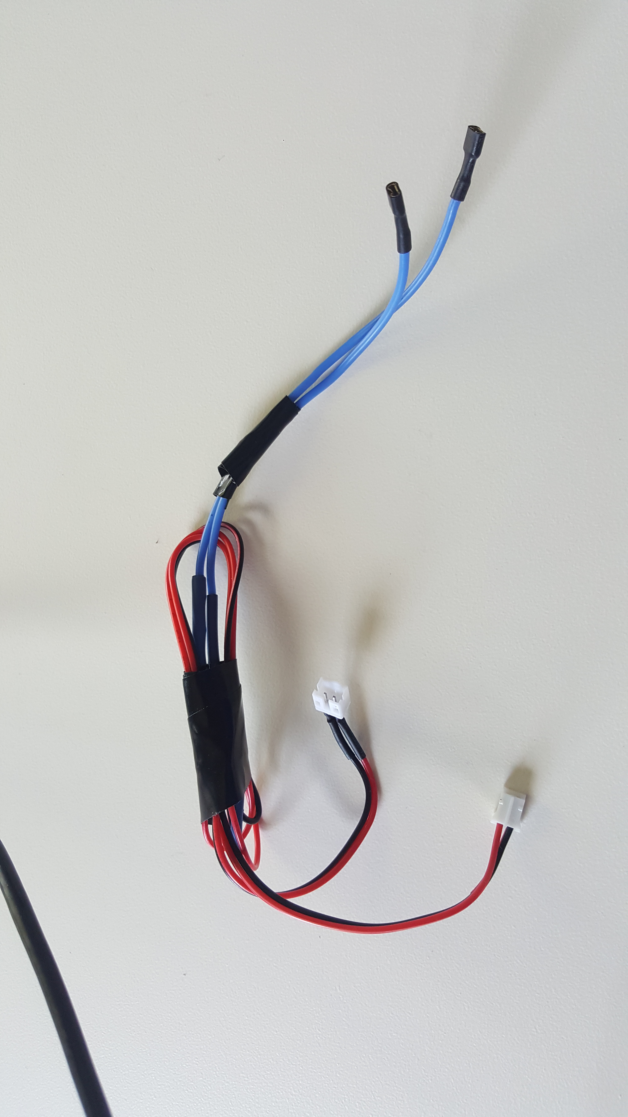
[picture p67: Documentation/Images/SwitchCable.jpg]
Documentation/Images/SwitchCable.jpg
