bruprescott/CTDizzle/Arduino_MKRZero_Mk4/Documentation/Images/ProtoboardWiring.jpg

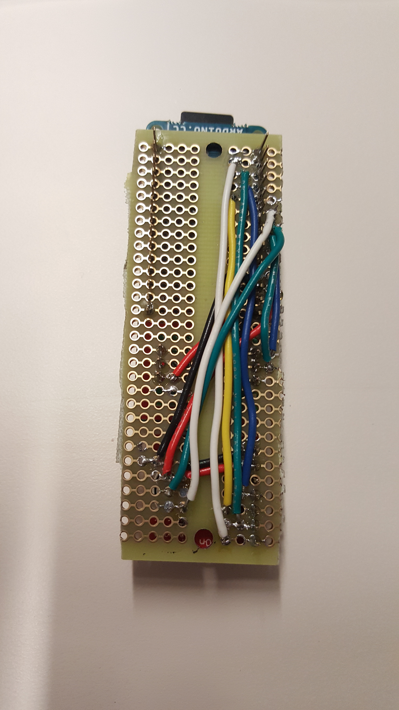
Arduino_MKRZero_Mk4/Documentation/Images/ProtoboardWiring.jpg
