bruprescott/CTDizzle/Arduino_MKRZero_Mk4/Documentation/Images/SolderingWires.jpg

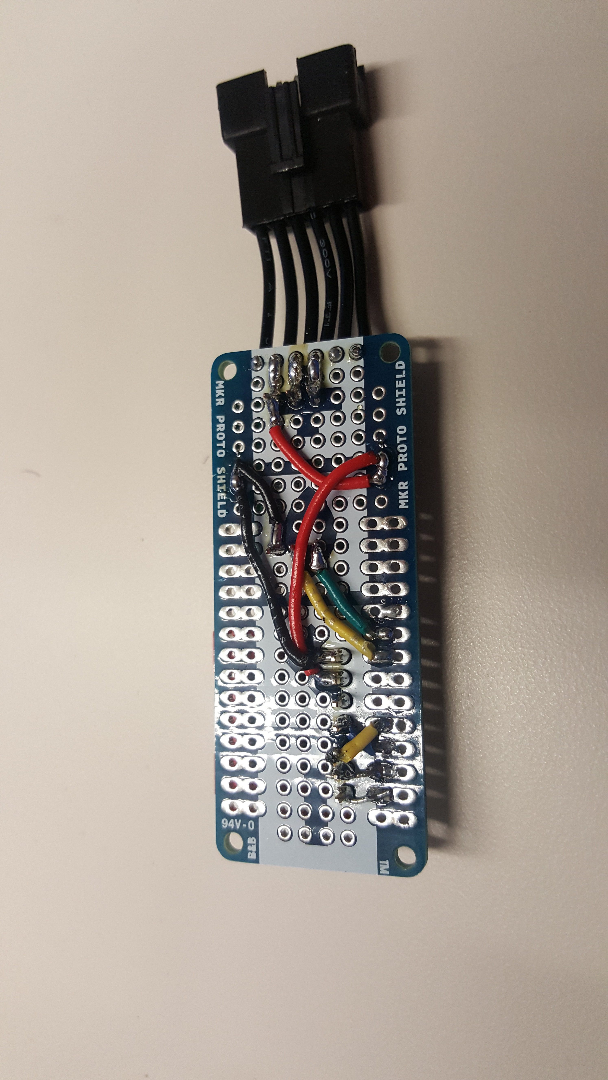
Arduino_MKRZero_Mk4/Documentation/Images/SolderingWires.jpg
