bruprescott/CTDizzle/Arduino_MKRZero_Mk4/Documentation/Images/SolderWires2.jpg

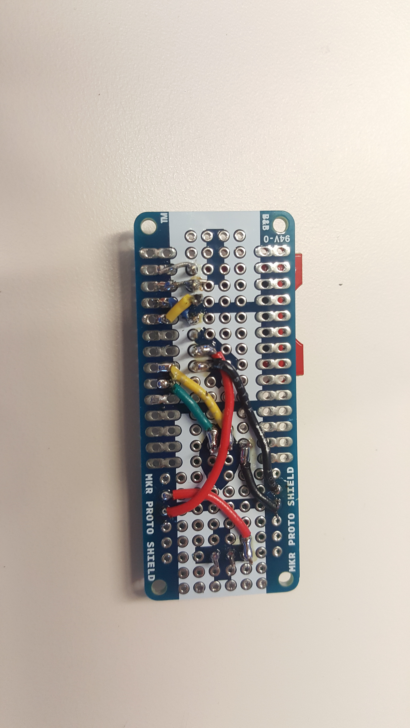
Arduino_MKRZero_Mk4/Documentation/Images/SolderWires2.jpg
