bruprescott/CTDizzle/Arduino_MKRZero_Mk4/Documentation/Images/UrethaneSetup2.jpg

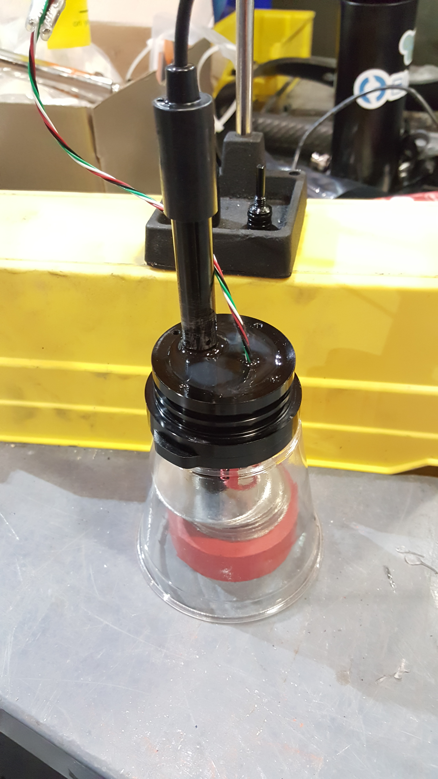
Arduino_MKRZero_Mk4/Documentation/Images/UrethaneSetup2.jpg
