bruprescott/CTDizzle/Arduino_MKRZero_Mk4/Documentation/Images/FinalTest.jpg

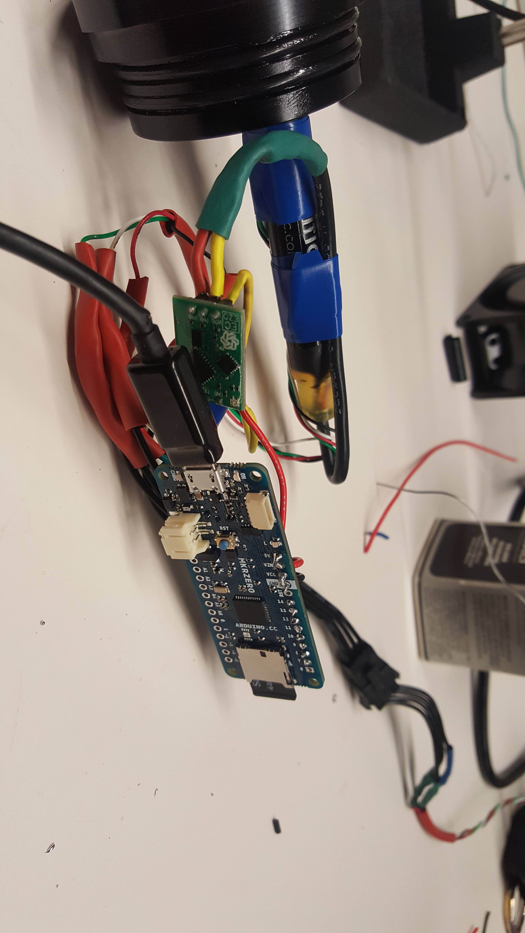
Arduino_MKRZero_Mk4/Documentation/Images/FinalTest.jpg
